napatkitiprasanpong/Closed-Loop-Smart-Insole-for-Diabetic-Foot-Ulcer-Prevention/esp32/esp32s3_insole_board_schematic.pdf

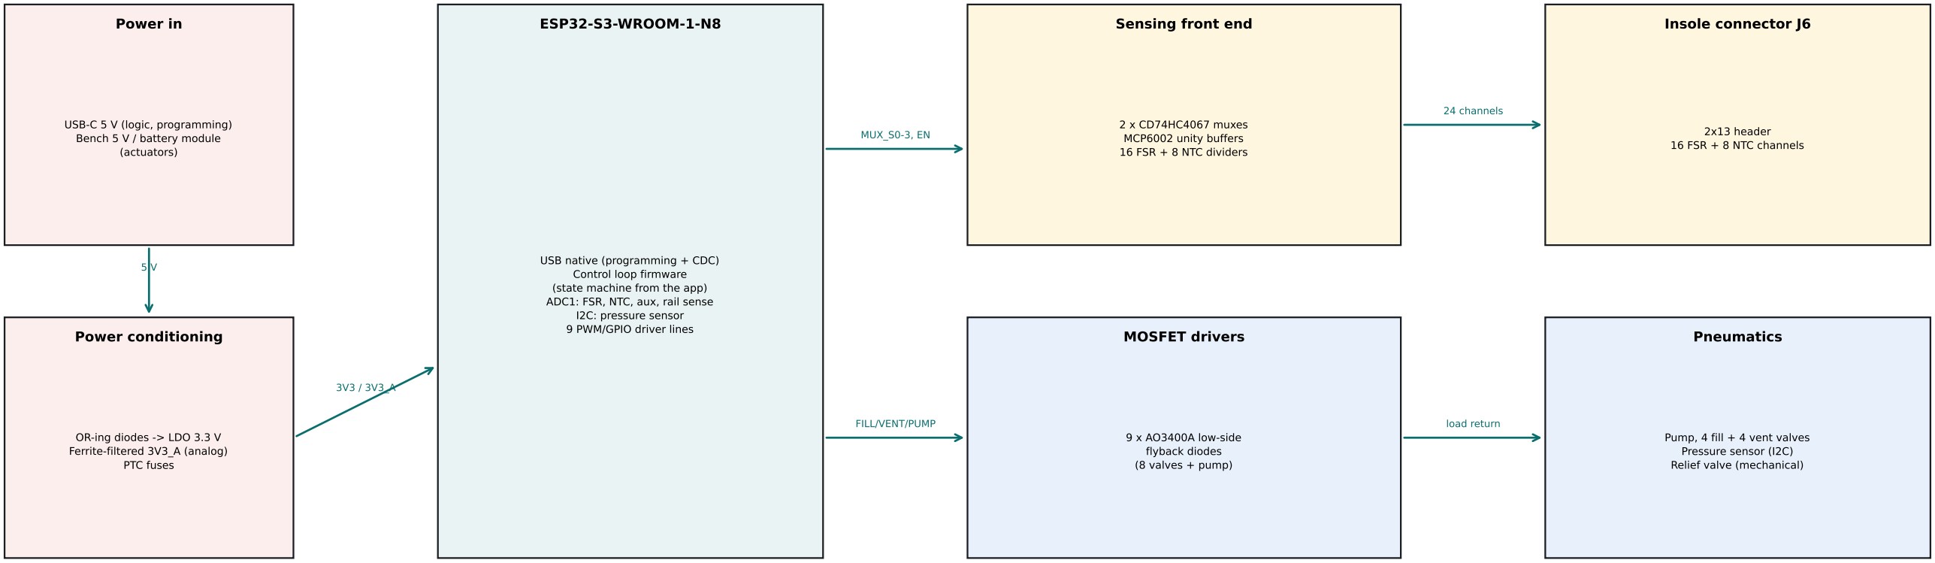
[picture p2: figure]
Power in; USB-C 5 V (logic, programming) Bench 5 V / battery module (actuators); Power conditioning; OR-ing diodes -> LDO 3.3 V Ferrite-filtered 3V3_A (analog) PTC fuses; ESP32-S3-WROOM-1-N8; USB native (programming + CDC) Control loop firmware (state machine from the app) ADC1: FSR, NTC, aux, rail sense I2C: pressure sensor 9 PWM/GPIO driver lines; Sensing front end; 2 x CD74HC4067 muxes MCP6002 unity buffers 16 FSR + 8 NTC dividers; Insole connector J6; 2x13 header 16 FSR + 8 NTC channels; MOSFET drivers; 9 x AO3400A low-side flyback diodes (8 valves + pump); Pneumatics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

### Closed-loop diabetic-foot insole: controller board (ESP32-S3)

Sheet 1/5: System overview and GPIO map | Rev 0.1 concept, 2026-10-03

### Safety path (independent of firmware)

Normally-closed E-stop switch in series with the actuator rail (J3) -> 2.5 A PTC -> V_ACT. Actuator power is cut in hardware; the MCU senses V_ACT on IO5 and stays powered.

Safe state: all valves and the pump are normally off (de-energised) when power is lost or the E-stop opens, so every bladder holds its last pressure. Vent valves are normally closed: a powered vent (or the mechanical relief valve) is needed to release pressure. Choose valve types accordingly.

Assumed loads (to confirm with real parts)

MCU module: about 100-350 mA (Wi-Fi bursts) | analog section: <20 mA
Actuator rail sized for 2.5 A (pump about 0.3-1 A, valves about 0.1-0.25 A each, only some energised at once)

### GPIO assignment

IO0 | BOOT | strapping: BOOT button
IO1 | FSR_ADC | ADC1_CH0
IO2 | NTC_ADC | ADC1_CH1
IO4 | AUX_ADC | ADC1_CH3, expansion header
IO5 | ACT_SENSE | ADC1_CH4, V_ACT sense
IO6 | AUX_IO | expansion header
IO7 | LED_STATUS
IO8 | I2C_SDA
IO9 | I2C_SCL
IO10 | MUX_S0
IO11 | MUX_S1
IO12 | MUX_S2
IO13 | MUX_S3
IO14 | MUX_EN_N
IO15 | FILL1
IO16 | FILL2
IO17 | FILL3
IO18 | FILL4
IO19 | USB_DN | native USB D-
IO20 | USB_DP | native USB D+
IO21 | VENT1
IO38 | VENT2
IO39 | VENT3
IO40 | VENT4
IO41 | PUMP_PWM
IO42 | BUZZER
IO43 | UART0_TX | UART0 TX
IO44 | UART0_RX | UART0 RX

Not used (reserved): IO3, IO45, IO46 (strapping), IO26-IO32 (flash), IO35-IO37 (octal-PSRAM variants), IO47/IO48. IO39-IO42 are the default pad-JTAG pins; debugging uses the USB Serial/JTAG port instead.

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

Sheet 3/5: Sensor front end: multiplexers, buffers, dividers, insole connector | Rev 0.1 concept, 2026-10-03

U3

CD74HC4067M (FSR)

FSR_N0 | I0
FSR_N1 | I1
FSR_N2 | I2
FSR_N3 | I3
FSR_N4 | I4
FSR_N5 | I5
FSR_N6 | I6
FSR_N7 | I7
FSR_N8 | I8
FSR_N9 | I9
FSR_N10 | I10
FSR_N11 | I11
FSR_N12 | I12
FSR_N13 | I13
FSR_N14 | I14
FSR_N15 | I15
S0 | MUX_S0
S1 | MUX_S1
S2 | MUX_S2
S3 | MUX_S3
~E | MUX_EN_N
GND | GND
VCC | 3V3_A
COM | FSR_MUX

U4

CD74HC4067M (NTC)

NTC_N0 | I0
NTC_N1 | I1
NTC_N2 | I2
NTC_N3 | I3
NTC_N4 | I4
NTC_N5 | I5
NTC_N6 | I6
NTC_N7 | I7
GND | I8
GND | I9
GND | I10
GND | I11
GND | I12
GND | I13
GND | I14
GND | I15
S0 | MUX_S0
S1 | MUX_S1
S2 | MUX_S2
S3 | MUX_S3
~E | MUX_EN_N
GND | GND
VCC | 3V3_A
COM | NTC_MUX

U5

MCP6002

FSR_BUF | 1
FSR_BUF | 2
FSR_MUX | 3
GND | 4
8 | 3V3_A
7 | NTC_BUF
6 | NTC_BUF
5 | NTC_MUX

J6

SENSORS

3V3_A | 1
FSR_N0 | 2
FSR_N1 | 3
FSR_N2 | 4
FSR_N3 | 5
FSR_N4 | 6
FSR_N5 | 7
FSR_N6 | 8
FSR_N7 | 9
FSR_N8 | 10
FSR_N9 | 11
FSR_N10 | 12
FSR_N11 | 13
FSR_N12 | 14
FSR_N13 | 15
FSR_N14 | 16
FSR_N15 | 17
GND | 18
NTC_N0 | 19
NTC_N1 | 20
NTC_N2 | 21
NTC_N3 | 22
NTC_N4 | 23
NTC_N5 | 24
NTC_N6 | 25
NTC_N7 | 26

Per-channel dividers

FSR (x16): sensor from 3V3_A (J6 pin 1)
to FSR_Nx; RFx 10k from FSR_Nx to GND.
NTC (x8): RNx 10k 0.1% from 3V3_A to NTC_Nx; thermistor from NTC_Nx to GND (J6 pin 18). Unused/unplugged channels read 0 V (FSR)
or near 3V3_A (NTC): no floating inputs.
FSR_N0 | GND

RF0 10k

FSR_N1 | GND

RF1 10k

3V3_A | NTC_N0

RN0 10k

3V3_A | NTC_N1

RN1 10k

(RF0-RF15 and RN0-RN7 follow the same pattern; see netlist.csv for all channels.)

Buffer outputs and ADC filters

FSR_BUF | FSR_ADC

R10 1k

FSR_ADC | GND

C12 100nF

NTC_BUF | NTC_ADC

R11 1k

NTC_ADC | GND

C13 100nF

Decoupling at U3, U4, U5 (100 nF each)

3V3_A | GND

C9 100nF

3V3_A | GND

C10 100nF

3V3_A | GND

C11 100nF

Mux enable pull-up

3V3 | MUX_EN_N

R9 10k

Scan: set S0-S3, wait about 0.3 ms, read FSR_ADC (IO1) and NTC_ADC (IO2) together. U4 inputs I8-I15 are tied to GND. Ron of the mux is
absorbed by the op-amp buffers.

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

Sheet 5/5: Suggested placement (floorplan, not a routed layout) | Rev 0.1 concept, 2026-10-03

Board outline about 90 x 65 mm (drawn at 3:1). 4-layer stack recommended: signal / GND / power / signal.

ESP32-S3-
WROOM-1
(18 x 25.5 mm)

antenna end at the board edge: no copper, GND or parts under or beside it

USB-C

Buttons,
LEDs,
debug

Power: LDO,
OR-ing diodes,
fuses

Analog: 2 muxes,
op-amp, dividers

J6 sensor header (bottom edge)

Actuator drivers:
MOSFETs, diodes,
bulk caps

Valve / pump / E-stop / bench terminals (right edge)

Placement guidance

1. Antenna at the board edge. 2. USB D+/D- as a short, matched pair with no stubs. 3. Switching loads (pump, valves) on the right, analog on the left.
4. J6 and the ADC filters next to the muxes; keep actuator return currents out from under the analog section. 5. Solid GND plane under the muxes and op-amp.
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
