napatkitiprasanpong/Closed-Loop-Smart-Insole-for-Diabetic-Foot-Ulcer-Prevention/esp32/sheet2.png

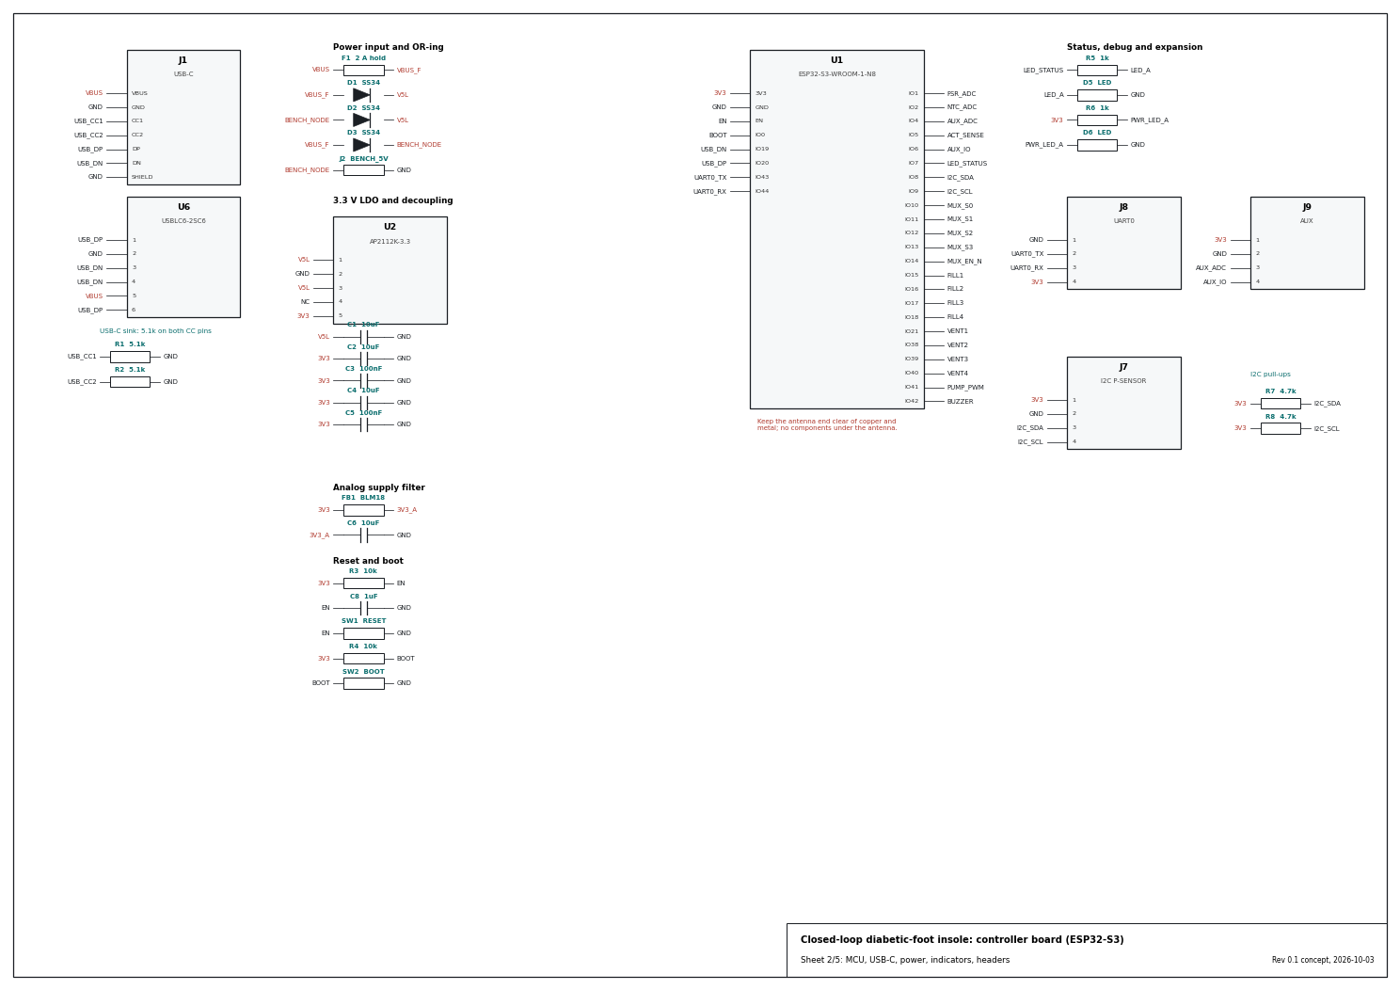
esp32/sheet2.png
