napatkitiprasanpong/Closed-Loop-Smart-Insole-for-Diabetic-Foot-Ulcer-Prevention/insole-cad/plan_view.png

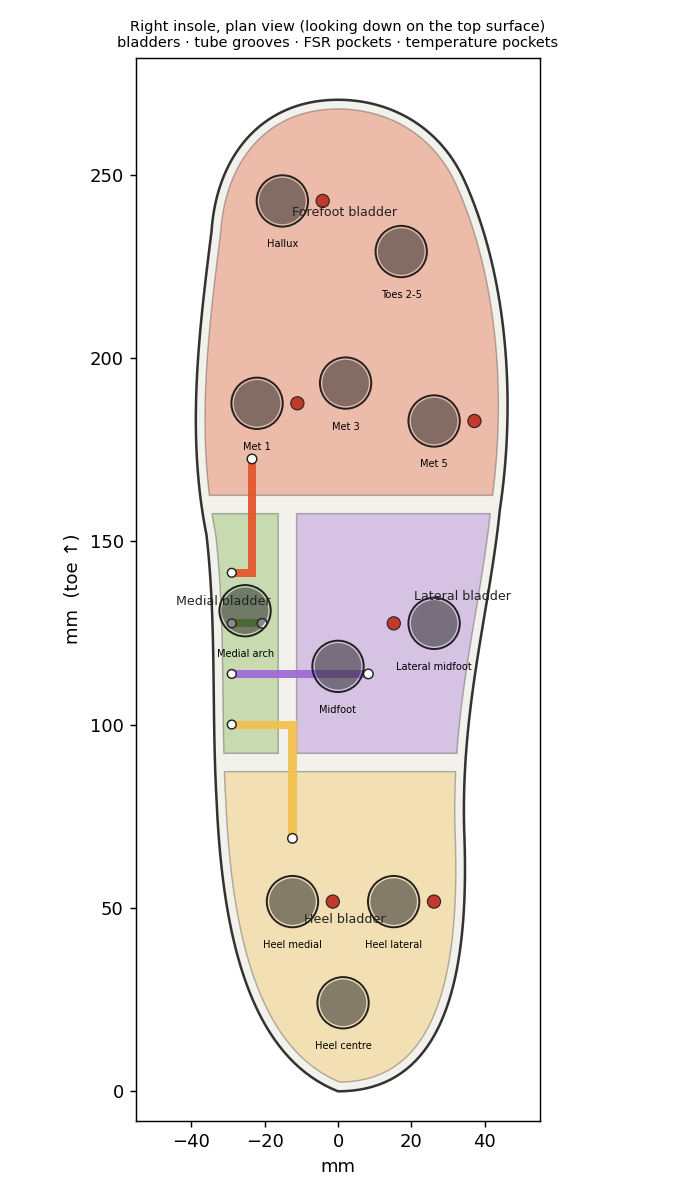
insole-cad/plan_view.png
