napatkitiprasanpong/Closed-Loop-Smart-Insole-for-Diabetic-Foot-Ulcer-Prevention/esp32/BOM.xlsx

Controller board BOM (concept rev 0.1)
Part numbers are given only where I am confident of them; other lines are generic specs. Check every line against current datasheets and stock before ordering.
Designators | Qty | Description | Value | Footprint | Part number | Notes
J1 | 1 | USB-C receptacle (USB 2.0, 16-pin) | USB-C | USB_C_Receptacle_16P | GCT USB4105-GF-A
J2 | 1 | Bench 5 V input / battery-module input (screw terminal 5.08 mm) | BENCH_5V | TerminalBlock_5.08_2P
J3 | 1 | E-stop switch terminal (normally-closed) | E-STOP | TerminalBlock_5.08_2P
J4 | 1 | Pump terminal | PUMP | JST_XH_1x02
J5 | 1 | Valve block header (1x9, 2.54 mm) | VALVES | PinHeader_1x09 |  | Pin 1 = valve supply (common), 2-5 = fill valves 1-4, 6-9 = vent valves 1-4
J6 | 1 | Insole sensor connector (2x13, 2.54 mm) | SENSORS | PinHeader_2x13 |  | Pin 1 = sensor supply (FSR common), 2-17 = FSR 0-15, 18 = sensor GND, 19-26 = NTC 0-7. Add TVS/ESD arrays here in layout
J7 | 1 | I2C pressure-sensor header (1x4, JST-SH) | I2C P-SENSOR | JST_SH_1x04 |  | For an I2C gauge pressure sensor module (range about 0 to 100 kPa). Part choice still open
J8 | 1 | Debug UART header (1x4, 2.54 mm) | UART0 | PinHeader_1x04
J9 | 1 | Expansion header (1x4, 2.54 mm) | AUX | PinHeader_1x04
Q1 | 1 | N-MOSFET low-side driver, Fill valve 1 | AO3400A | SOT-23 | AO3400A
Q2 | 1 | N-MOSFET low-side driver, Fill valve 2 | AO3400A | SOT-23 | AO3400A
Q3 | 1 | N-MOSFET low-side driver, Fill valve 3 | AO3400A | SOT-23 | AO3400A
Q4 | 1 | N-MOSFET low-side driver, Fill valve 4 | AO3400A | SOT-23 | AO3400A
Q5 | 1 | N-MOSFET low-side driver, Vent valve 1 | AO3400A | SOT-23 | AO3400A
Q6 | 1 | N-MOSFET low-side driver, Vent valve 2 | AO3400A | SOT-23 | AO3400A
Q7 | 1 | N-MOSFET low-side driver, Vent valve 3 | AO3400A | SOT-23 | AO3400A
Q8 | 1 | N-MOSFET low-side driver, Vent valve 4 | AO3400A | SOT-23 | AO3400A
Q9 | 1 | N-MOSFET low-side driver, Pump | AO3400A | SOT-23 | AO3400A
Q10 | 1 | N-MOSFET low-side driver, buzzer | AO3400A | SOT-23 | AO3400A
U1 | 1 | ESP32-S3 module, 8 MB flash, no PSRAM | ESP32-S3-WROOM-1-N8 | ESP32-S3-WROOM-1 | ESP32-S3-WROOM-1-N8 | Pins keyed by IO number; map to pad numbers from the KiCad library symbol
U2 | 1 | 3.3 V LDO, 600 mA | AP2112K-3.3 | SOT-23-5 | AP2112K-3.3TRG1
U3 | 1 | 16:1 analog multiplexer (FSR) | CD74HC4067M | SOIC-24W | CD74HC4067M
U4 | 1 | 16:1 analog multiplexer (NTC) | CD74HC4067M | SOIC-24W | CD74HC4067M
U5 | 1 | Dual rail-to-rail op-amp, unity-gain buffers | MCP6002 | SOIC-8 | MCP6002-I/SN
U6 | 1 | USB ESD protection | USBLC6-2SC6 | SOT-23-6 | USBLC6-2SC6
C1, C2, C4, C6, C15 | 5 | Capacitor | 10uF | C_0805
C3, C5, C7, C9, C10, C11, C12, C13, C16 | 9 | Capacitor | 100nF | C_0603
C8 | 1 | Capacitor | 1uF | C_0603
C14 | 1 | Capacitor | 220uF | CP_6.3x5.4
D1, D2 | 2 | Schottky diode | SS34 | D_SMA | SS34
D3 | 1 | Schottky diode | SS34 | D_SMA | SS34 | DNP by default. Populate for single-cable bench mode (USB powers actuators too; limited by the USB source)
D5 | 1 | LED green (status) | LED | LED_0603
D6 | 1 | LED red (power) | LED | LED_0603
D20, D21, D22, D23, D24, D25, D26, D27 | 8 | Flyback diode | SS14 | D_SMA | SS14
D28 | 1 | Flyback diode | SS34 | D_SMA | SS34
F1 | 1 | Resettable fuse, USB input | 2 A hold | F_1812 |  | PTC
FB1 | 1 | Ferrite bead 600 ohm @100 MHz, 1 A | BLM18 | L_0603
F2 | 1 | Resettable fuse, actuator rail | 2.5 A hold | F_1812 |  | PTC
LS1 | 1 | Active buzzer, 3.3 V | BUZZER | Buzzer_12x9.5 |  | If a magnetic buzzer is used, add a flyback diode
R1, R2 | 2 | Resistor | 5.1k | R_0603
RF0, RN0, RF1, RN1, RF2, RN2, R3, RF3, RN3, R4, RF4, RN4, RF5, RN5, RF6, RN6, RF7, RN7, RF8, R9, RF9, RF10, RF11, RF12, R12, RF13, RF14, RF15 | 28 | Resistor | 10k | R_0603
R5, R6, R10, R11 | 4 | Resistor | 1k | R_0603
R7, R8 | 2 | Resistor | 4.7k | R_0603
R13 | 1 | Resistor | 15k | R_0603
R14, R16, R18, R20, R22, R24, R26, R28, R30, R32 | 10 | Resistor | 100 | R_0603
R15, R17, R19, R21, R23, R25, R27, R29, R31, R33 | 10 | Resistor | 100k | R_0603
SW1 | 1 | Tactile switch (RESET) | RESET | SW_SMD_3x4
SW2 | 1 | Tactile switch (BOOT) | BOOT | SW_SMD_3x4
