napatkitiprasanpong/Closed-Loop-Smart-Insole-for-Diabetic-Foot-Ulcer-Prevention/esp32/netlist.csv

ref | pin | net | part_value | footprint
C1 | 1 | V5L | 10uF | C_0805
C1 | 2 | GND | 10uF | C_0805
C2 | 1 | 3V3 | 10uF | C_0805
C2 | 2 | GND | 10uF | C_0805
C3 | 1 | 3V3 | 100nF | C_0603
C3 | 2 | GND | 100nF | C_0603
C4 | 1 | 3V3 | 10uF | C_0805
C4 | 2 | GND | 10uF | C_0805
C5 | 1 | 3V3 | 100nF | C_0603
C5 | 2 | GND | 100nF | C_0603
C6 | 1 | 3V3_A | 10uF | C_0805
C6 | 2 | GND | 10uF | C_0805
C7 | 1 | 3V3_A | 100nF | C_0603
C7 | 2 | GND | 100nF | C_0603
C8 | 1 | EN | 1uF | C_0603
C8 | 2 | GND | 1uF | C_0603
C9 | 1 | 3V3_A | 100nF | C_0603
C9 | 2 | GND | 100nF | C_0603
C10 | 1 | 3V3_A | 100nF | C_0603
C10 | 2 | GND | 100nF | C_0603
C11 | 1 | 3V3_A | 100nF | C_0603
C11 | 2 | GND | 100nF | C_0603
C12 | 1 | FSR_ADC | 100nF | C_0603
C12 | 2 | GND | 100nF | C_0603
C13 | 1 | NTC_ADC | 100nF | C_0603
C13 | 2 | GND | 100nF | C_0603
C14 | 1 | V_ACT | 220uF | CP_6.3x5.4
C14 | 2 | GND | 220uF | CP_6.3x5.4
C15 | 1 | V_ACT | 10uF | C_0805
C15 | 2 | GND | 10uF | C_0805
C16 | 1 | ACT_SENSE | 100nF | C_0603
C16 | 2 | GND | 100nF | C_0603
D1 | A | VBUS_F | SS34 | D_SMA
D1 | K | V5L | SS34 | D_SMA
D2 | A | BENCH_NODE | SS34 | D_SMA
D2 | K | V5L | SS34 | D_SMA
D3 | A | VBUS_F | SS34 | D_SMA
D3 | K | BENCH_NODE | SS34 | D_SMA
D5 | A | LED_A | LED | LED_0603
D5 | K | GND | LED | LED_0603
D6 | A | PWR_LED_A | LED | LED_0603
D6 | K | GND | LED | LED_0603
D20 | A | DRV_FILL1 | SS14 | D_SMA
D20 | K | V_ACT | SS14 | D_SMA
D21 | A | DRV_FILL2 | SS14 | D_SMA
D21 | K | V_ACT | SS14 | D_SMA
D22 | A | DRV_FILL3 | SS14 | D_SMA
D22 | K | V_ACT | SS14 | D_SMA
D23 | A | DRV_FILL4 | SS14 | D_SMA
D23 | K | V_ACT | SS14 | D_SMA
D24 | A | DRV_VENT1 | SS14 | D_SMA
D24 | K | V_ACT | SS14 | D_SMA
D25 | A | DRV_VENT2 | SS14 | D_SMA
D25 | K | V_ACT | SS14 | D_SMA
D26 | A | DRV_VENT3 | SS14 | D_SMA
D26 | K | V_ACT | SS14 | D_SMA
D27 | A | DRV_VENT4 | SS14 | D_SMA
D27 | K | V_ACT | SS14 | D_SMA
D28 | A | PUMP_N | SS34 | D_SMA
D28 | K | V_ACT | SS34 | D_SMA
F1 | 1 | VBUS | 2 A hold | F_1812
F1 | 2 | VBUS_F | 2 A hold | F_1812
FB1 | 1 | 3V3 | BLM18 | L_0603
FB1 | 2 | 3V3_A | BLM18 | L_0603
F2 | 1 | ESTOP_OUT | 2.5 A hold | F_1812
F2 | 2 | V_ACT | 2.5 A hold | F_1812
J1 | VBUS | VBUS | USB-C | USB_C_Receptacle_16P
J1 | GND | GND | USB-C | USB_C_Receptacle_16P
J1 | CC1 | USB_CC1 | USB-C | USB_C_Receptacle_16P
J1 | CC2 | USB_CC2 | USB-C | USB_C_Receptacle_16P
J1 | DP | USB_DP | USB-C | USB_C_Receptacle_16P
J1 | DN | USB_DN | USB-C | USB_C_Receptacle_16P
J1 | SHIELD | GND | USB-C | USB_C_Receptacle_16P
J2 | 1 | BENCH_NODE | BENCH_5V | TerminalBlock_5.08_2P
J2 | 2 | GND | BENCH_5V | TerminalBlock_5.08_2P
J3 | 1 | BENCH_NODE | E-STOP | TerminalBlock_5.08_2P
J3 | 2 | ESTOP_OUT | E-STOP | TerminalBlock_5.08_2P
J4 | 1 | V_ACT | PUMP | JST_XH_1x02
J4 | 2 | PUMP_N | PUMP | JST_XH_1x02
J5 | 1 | V_ACT | VALVES | PinHeader_1x09
J5 | 2 | DRV_FILL1 | VALVES | PinHeader_1x09
J5 | 3 | DRV_FILL2 | VALVES | PinHeader_1x09
J5 | 4 | DRV_FILL3 | VALVES | PinHeader_1x09
J5 | 5 | DRV_FILL4 | VALVES | PinHeader_1x09
J5 | 6 | DRV_VENT1 | VALVES | PinHeader_1x09
J5 | 7 | DRV_VENT2 | VALVES | PinHeader_1x09
J5 | 8 | DRV_VENT3 | VALVES | PinHeader_1x09
J5 | 9 | DRV_VENT4 | VALVES | PinHeader_1x09
J6 | 1 | 3V3_A | SENSORS | PinHeader_2x13
J6 | 2 | FSR_N0 | SENSORS | PinHeader_2x13
J6 | 3 | FSR_N1 | SENSORS | PinHeader_2x13
J6 | 4 | FSR_N2 | SENSORS | PinHeader_2x13
J6 | 5 | FSR_N3 | SENSORS | PinHeader_2x13
J6 | 6 | FSR_N4 | SENSORS | PinHeader_2x13
J6 | 7 | FSR_N5 | SENSORS | PinHeader_2x13
J6 | 8 | FSR_N6 | SENSORS | PinHeader_2x13
J6 | 9 | FSR_N7 | SENSORS | PinHeader_2x13
J6 | 10 | FSR_N8 | SENSORS | PinHeader_2x13
J6 | 11 | FSR_N9 | SENSORS | PinHeader_2x13
J6 | 12 | FSR_N10 | SENSORS | PinHeader_2x13
J6 | 13 | FSR_N11 | SENSORS | PinHeader_2x13
J6 | 14 | FSR_N12 | SENSORS | PinHeader_2x13
J6 | 15 | FSR_N13 | SENSORS | PinHeader_2x13
J6 | 16 | FSR_N14 | SENSORS | PinHeader_2x13
J6 | 17 | FSR_N15 | SENSORS | PinHeader_2x13
J6 | 18 | GND | SENSORS | PinHeader_2x13
J6 | 19 | NTC_N0 | SENSORS | PinHeader_2x13
J6 | 20 | NTC_N1 | SENSORS | PinHeader_2x13
J6 | 21 | NTC_N2 | SENSORS | PinHeader_2x13
J6 | 22 | NTC_N3 | SENSORS | PinHeader_2x13
J6 | 23 | NTC_N4 | SENSORS | PinHeader_2x13
J6 | 24 | NTC_N5 | SENSORS | PinHeader_2x13
J6 | 25 | NTC_N6 | SENSORS | PinHeader_2x13
J6 | 26 | NTC_N7 | SENSORS | PinHeader_2x13
J7 | 1 | 3V3 | I2C P-SENSOR | JST_SH_1x04
J7 | 2 | GND | I2C P-SENSOR | JST_SH_1x04
J7 | 3 | I2C_SDA | I2C P-SENSOR | JST_SH_1x04
J7 | 4 | I2C_SCL | I2C P-SENSOR | JST_SH_1x04
J8 | 1 | GND | UART0 | PinHeader_1x04
J8 | 2 | UART0_TX | UART0 | PinHeader_1x04
J8 | 3 | UART0_RX | UART0 | PinHeader_1x04
J8 | 4 | 3V3 | UART0 | PinHeader_1x04
J9 | 1 | 3V3 | AUX | PinHeader_1x04
J9 | 2 | GND | AUX | PinHeader_1x04
J9 | 3 | AUX_ADC | AUX | PinHeader_1x04
J9 | 4 | AUX_IO | AUX | PinHeader_1x04
LS1 | 1 | 3V3 | BUZZER | Buzzer_12x9.5
LS1 | 2 | BZ_N | BUZZER | Buzzer_12x9.5
Q1 | 1 | G_FILL1 | AO3400A | SOT-23
Q1 | 2 | GND | AO3400A | SOT-23
Q1 | 3 | DRV_FILL1 | AO3400A | SOT-23
Q2 | 1 | G_FILL2 | AO3400A | SOT-23
Q2 | 2 | GND | AO3400A | SOT-23
Q2 | 3 | DRV_FILL2 | AO3400A | SOT-23
Q3 | 1 | G_FILL3 | AO3400A | SOT-23
Q3 | 2 | GND | AO3400A | SOT-23
Q3 | 3 | DRV_FILL3 | AO3400A | SOT-23
Q4 | 1 | G_FILL4 | AO3400A | SOT-23
Q4 | 2 | GND | AO3400A | SOT-23
Q4 | 3 | DRV_FILL4 | AO3400A | SOT-23
Q5 | 1 | G_VENT1 | AO3400A | SOT-23
Q5 | 2 | GND | AO3400A | SOT-23
Q5 | 3 | DRV_VENT1 | AO3400A | SOT-23
Q6 | 1 | G_VENT2 | AO3400A | SOT-23
Q6 | 2 | GND | AO3400A | SOT-23
Q6 | 3 | DRV_VENT2 | AO3400A | SOT-23
Q7 | 1 | G_VENT3 | AO3400A | SOT-23
Q7 | 2 | GND | AO3400A | SOT-23
Q7 | 3 | DRV_VENT3 | AO3400A | SOT-23
Q8 | 1 | G_VENT4 | AO3400A | SOT-23
Q8 | 2 | GND | AO3400A | SOT-23
Q8 | 3 | DRV_VENT4 | AO3400A | SOT-23
Q9 | 1 | G_PUMP | AO3400A | SOT-23
Q9 | 2 | GND | AO3400A | SOT-23
Q9 | 3 | PUMP_N | AO3400A | SOT-23
Q10 | 1 | G_BZ | AO3400A | SOT-23
Q10 | 2 | GND | AO3400A | SOT-23
Q10 | 3 | BZ_N | AO3400A | SOT-23
RF0 | 1 | FSR_N0 | 10k | R_0603
RF0 | 2 | GND | 10k | R_0603
RN0 | 1 | 3V3_A | 10k | R_0603
RN0 | 2 | NTC_N0 | 10k | R_0603
R1 | 1 | USB_CC1 | 5.1k | R_0603
R1 | 2 | GND | 5.1k | R_0603
RF1 | 1 | FSR_N1 | 10k | R_0603
RF1 | 2 | GND | 10k | R_0603
RN1 | 1 | 3V3_A | 10k | R_0603
RN1 | 2 | NTC_N1 | 10k | R_0603
R2 | 1 | USB_CC2 | 5.1k | R_0603
R2 | 2 | GND | 5.1k | R_0603
RF2 | 1 | FSR_N2 | 10k | R_0603
RF2 | 2 | GND | 10k | R_0603
RN2 | 1 | 3V3_A | 10k | R_0603
RN2 | 2 | NTC_N2 | 10k | R_0603
R3 | 1 | 3V3 | 10k | R_0603
R3 | 2 | EN | 10k | R_0603
RF3 | 1 | FSR_N3 | 10k | R_0603
RF3 | 2 | GND | 10k | R_0603
RN3 | 1 | 3V3_A | 10k | R_0603
RN3 | 2 | NTC_N3 | 10k | R_0603
R4 | 1 | 3V3 | 10k | R_0603
R4 | 2 | BOOT | 10k | R_0603
RF4 | 1 | FSR_N4 | 10k | R_0603
RF4 | 2 | GND | 10k | R_0603
RN4 | 1 | 3V3_A | 10k | R_0603
RN4 | 2 | NTC_N4 | 10k | R_0603
R5 | 1 | LED_STATUS | 1k | R_0603
R5 | 2 | LED_A | 1k | R_0603
RF5 | 1 | FSR_N5 | 10k | R_0603
RF5 | 2 | GND | 10k | R_0603
RN5 | 1 | 3V3_A | 10k | R_0603
RN5 | 2 | NTC_N5 | 10k | R_0603
R6 | 1 | 3V3 | 1k | R_0603
R6 | 2 | PWR_LED_A | 1k | R_0603
RF6 | 1 | FSR_N6 | 10k | R_0603
RF6 | 2 | GND | 10k | R_0603
RN6 | 1 | 3V3_A | 10k | R_0603
RN6 | 2 | NTC_N6 | 10k | R_0603
R7 | 1 | 3V3 | 4.7k | R_0603
R7 | 2 | I2C_SDA | 4.7k | R_0603
RF7 | 1 | FSR_N7 | 10k | R_0603
RF7 | 2 | GND | 10k | R_0603
RN7 | 1 | 3V3_A | 10k | R_0603
RN7 | 2 | NTC_N7 | 10k | R_0603
R8 | 1 | 3V3 | 4.7k | R_0603
R8 | 2 | I2C_SCL | 4.7k | R_0603
RF8 | 1 | FSR_N8 | 10k | R_0603
RF8 | 2 | GND | 10k | R_0603
R9 | 1 | 3V3 | 10k | R_0603
R9 | 2 | MUX_EN_N | 10k | R_0603
RF9 | 1 | FSR_N9 | 10k | R_0603
RF9 | 2 | GND | 10k | R_0603
R10 | 1 | FSR_BUF | 1k | R_0603
R10 | 2 | FSR_ADC | 1k | R_0603
RF10 | 1 | FSR_N10 | 10k | R_0603
RF10 | 2 | GND | 10k | R_0603
R11 | 1 | NTC_BUF | 1k | R_0603
R11 | 2 | NTC_ADC | 1k | R_0603
RF11 | 1 | FSR_N11 | 10k | R_0603
RF11 | 2 | GND | 10k | R_0603
RF12 | 1 | FSR_N12 | 10k | R_0603
RF12 | 2 | GND | 10k | R_0603
R12 | 1 | V_ACT | 10k | R_0603
R12 | 2 | ACT_SENSE | 10k | R_0603
RF13 | 1 | FSR_N13 | 10k | R_0603
RF13 | 2 | GND | 10k | R_0603
R13 | 1 | ACT_SENSE | 15k | R_0603
R13 | 2 | GND | 15k | R_0603
RF14 | 1 | FSR_N14 | 10k | R_0603
RF14 | 2 | GND | 10k | R_0603
R14 | 1 | FILL1 | 100 | R_0603
R14 | 2 | G_FILL1 | 100 | R_0603
RF15 | 1 | FSR_N15 | 10k | R_0603
RF15 | 2 | GND | 10k | R_0603
R15 | 1 | G_FILL1 | 100k | R_0603
R15 | 2 | GND | 100k | R_0603
R16 | 1 | FILL2 | 100 | R_0603
R16 | 2 | G_FILL2 | 100 | R_0603
R17 | 1 | G_FILL2 | 100k | R_0603
R17 | 2 | GND | 100k | R_0603
R18 | 1 | FILL3 | 100 | R_0603
R18 | 2 | G_FILL3 | 100 | R_0603
R19 | 1 | G_FILL3 | 100k | R_0603
R19 | 2 | GND | 100k | R_0603
R20 | 1 | FILL4 | 100 | R_0603
R20 | 2 | G_FILL4 | 100 | R_0603
R21 | 1 | G_FILL4 | 100k | R_0603
R21 | 2 | GND | 100k | R_0603
R22 | 1 | VENT1 | 100 | R_0603
R22 | 2 | G_VENT1 | 100 | R_0603
R23 | 1 | G_VENT1 | 100k | R_0603
R23 | 2 | GND | 100k | R_0603
R24 | 1 | VENT2 | 100 | R_0603
R24 | 2 | G_VENT2 | 100 | R_0603
R25 | 1 | G_VENT2 | 100k | R_0603
R25 | 2 | GND | 100k | R_0603
R26 | 1 | VENT3 | 100 | R_0603
R26 | 2 | G_VENT3 | 100 | R_0603
R27 | 1 | G_VENT3 | 100k | R_0603
R27 | 2 | GND | 100k | R_0603
R28 | 1 | VENT4 | 100 | R_0603
R28 | 2 | G_VENT4 | 100 | R_0603
R29 | 1 | G_VENT4 | 100k | R_0603
R29 | 2 | GND | 100k | R_0603
R30 | 1 | PUMP_PWM | 100 | R_0603
R30 | 2 | G_PUMP | 100 | R_0603
R31 | 1 | G_PUMP | 100k | R_0603
R31 | 2 | GND | 100k | R_0603
R32 | 1 | BUZZER | 100 | R_0603
R32 | 2 | G_BZ | 100 | R_0603
R33 | 1 | G_BZ | 100k | R_0603
R33 | 2 | GND | 100k | R_0603
SW1 | 1 | EN | RESET | SW_SMD_3x4
SW1 | 2 | GND | RESET | SW_SMD_3x4
SW2 | 1 | BOOT | BOOT | SW_SMD_3x4
SW2 | 2 | GND | BOOT | SW_SMD_3x4
U1 | 3V3 | 3V3 | ESP32-S3-WROOM-1-N8 | ESP32-S3-WROOM-1
U1 | GND | GND | ESP32-S3-WROOM-1-N8 | ESP32-S3-WROOM-1
U1 | EN | EN | ESP32-S3-WROOM-1-N8 | ESP32-S3-WROOM-1
U1 | IO0 | BOOT | ESP32-S3-WROOM-1-N8 | ESP32-S3-WROOM-1
U1 | IO1 | FSR_ADC | ESP32-S3-WROOM-1-N8 | ESP32-S3-WROOM-1
U1 | IO2 | NTC_ADC | ESP32-S3-WROOM-1-N8 | ESP32-S3-WROOM-1
U1 | IO4 | AUX_ADC | ESP32-S3-WROOM-1-N8 | ESP32-S3-WROOM-1
U1 | IO5 | ACT_SENSE | ESP32-S3-WROOM-1-N8 | ESP32-S3-WROOM-1
U1 | IO6 | AUX_IO | ESP32-S3-WROOM-1-N8 | ESP32-S3-WROOM-1
U1 | IO7 | LED_STATUS | ESP32-S3-WROOM-1-N8 | ESP32-S3-WROOM-1
U1 | IO8 | I2C_SDA | ESP32-S3-WROOM-1-N8 | ESP32-S3-WROOM-1
U1 | IO9 | I2C_SCL | ESP32-S3-WROOM-1-N8 | ESP32-S3-WROOM-1
U1 | IO10 | MUX_S0 | ESP32-S3-WROOM-1-N8 | ESP32-S3-WROOM-1
U1 | IO11 | MUX_S1 | ESP32-S3-WROOM-1-N8 | ESP32-S3-WROOM-1
U1 | IO12 | MUX_S2 | ESP32-S3-WROOM-1-N8 | ESP32-S3-WROOM-1
U1 | IO13 | MUX_S3 | ESP32-S3-WROOM-1-N8 | ESP32-S3-WROOM-1
U1 | IO14 | MUX_EN_N | ESP32-S3-WROOM-1-N8 | ESP32-S3-WROOM-1
U1 | IO15 | FILL1 | ESP32-S3-WROOM-1-N8 | ESP32-S3-WROOM-1
U1 | IO16 | FILL2 | ESP32-S3-WROOM-1-N8 | ESP32-S3-WROOM-1
U1 | IO17 | FILL3 | ESP32-S3-WROOM-1-N8 | ESP32-S3-WROOM-1
U1 | IO18 | FILL4 | ESP32-S3-WROOM-1-N8 | ESP32-S3-WROOM-1
U1 | IO19 | USB_DN | ESP32-S3-WROOM-1-N8 | ESP32-S3-WROOM-1
U1 | IO20 | USB_DP | ESP32-S3-WROOM-1-N8 | ESP32-S3-WROOM-1
U1 | IO21 | VENT1 | ESP32-S3-WROOM-1-N8 | ESP32-S3-WROOM-1
U1 | IO38 | VENT2 | ESP32-S3-WROOM-1-N8 | ESP32-S3-WROOM-1
U1 | IO39 | VENT3 | ESP32-S3-WROOM-1-N8 | ESP32-S3-WROOM-1
U1 | IO40 | VENT4 | ESP32-S3-WROOM-1-N8 | ESP32-S3-WROOM-1
U1 | IO41 | PUMP_PWM | ESP32-S3-WROOM-1-N8 | ESP32-S3-WROOM-1
U1 | IO42 | BUZZER | ESP32-S3-WROOM-1-N8 | ESP32-S3-WROOM-1
U1 | IO43 | UART0_TX | ESP32-S3-WROOM-1-N8 | ESP32-S3-WROOM-1
U1 | IO44 | UART0_RX | ESP32-S3-WROOM-1-N8 | ESP32-S3-WROOM-1
U2 | 1 | V5L | AP2112K-3.3 | SOT-23-5
U2 | 2 | GND | AP2112K-3.3 | SOT-23-5
U2 | 3 | V5L | AP2112K-3.3 | SOT-23-5
U2 | 4 | NC | AP2112K-3.3 | SOT-23-5
U2 | 5 | 3V3 | AP2112K-3.3 | SOT-23-5
U3 | 1 | FSR_MUX | CD74HC4067M | SOIC-24W
U3 | 10 | MUX_S0 | CD74HC4067M | SOIC-24W
U3 | 11 | MUX_S1 | CD74HC4067M | SOIC-24W
U3 | 12 | GND | CD74HC4067M | SOIC-24W
U3 | 13 | MUX_S3 | CD74HC4067M | SOIC-24W
U3 | 14 | MUX_S2 | CD74HC4067M | SOIC-24W
U3 | 15 | MUX_EN_N | CD74HC4067M | SOIC-24W
U3 | 24 | 3V3_A | CD74HC4067M | SOIC-24W
U3 | 9 | FSR_N0 | CD74HC4067M | SOIC-24W
U3 | 8 | FSR_N1 | CD74HC4067M | SOIC-24W
U3 | 7 | FSR_N2 | CD74HC4067M | SOIC-24W
U3 | 6 | FSR_N3 | CD74HC4067M | SOIC-24W
U3 | 5 | FSR_N4 | CD74HC4067M | SOIC-24W
U3 | 4 | FSR_N5 | CD74HC4067M | SOIC-24W
U3 | 3 | FSR_N6 | CD74HC4067M | SOIC-24W
U3 | 2 | FSR_N7 | CD74HC4067M | SOIC-24W
U3 | 23 | FSR_N8 | CD74HC4067M | SOIC-24W
U3 | 22 | FSR_N9 | CD74HC4067M | SOIC-24W
U3 | 21 | FSR_N10 | CD74HC4067M | SOIC-24W
U3 | 20 | FSR_N11 | CD74HC4067M | SOIC-24W
U3 | 19 | FSR_N12 | CD74HC4067M | SOIC-24W
U3 | 18 | FSR_N13 | CD74HC4067M | SOIC-24W
U3 | 17 | FSR_N14 | CD74HC4067M | SOIC-24W
U3 | 16 | FSR_N15 | CD74HC4067M | SOIC-24W
U4 | 1 | NTC_MUX | CD74HC4067M | SOIC-24W
U4 | 10 | MUX_S0 | CD74HC4067M | SOIC-24W
U4 | 11 | MUX_S1 | CD74HC4067M | SOIC-24W
U4 | 12 | GND | CD74HC4067M | SOIC-24W
U4 | 13 | MUX_S3 | CD74HC4067M | SOIC-24W
U4 | 14 | MUX_S2 | CD74HC4067M | SOIC-24W
U4 | 15 | MUX_EN_N | CD74HC4067M | SOIC-24W
U4 | 24 | 3V3_A | CD74HC4067M | SOIC-24W
U4 | 9 | NTC_N0 | CD74HC4067M | SOIC-24W
U4 | 8 | NTC_N1 | CD74HC4067M | SOIC-24W
U4 | 7 | NTC_N2 | CD74HC4067M | SOIC-24W
U4 | 6 | NTC_N3 | CD74HC4067M | SOIC-24W
U4 | 5 | NTC_N4 | CD74HC4067M | SOIC-24W
U4 | 4 | NTC_N5 | CD74HC4067M | SOIC-24W
U4 | 3 | NTC_N6 | CD74HC4067M | SOIC-24W
U4 | 2 | NTC_N7 | CD74HC4067M | SOIC-24W
U4 | 23 | GND | CD74HC4067M | SOIC-24W
U4 | 22 | GND | CD74HC4067M | SOIC-24W
U4 | 21 | GND | CD74HC4067M | SOIC-24W
U4 | 20 | GND | CD74HC4067M | SOIC-24W
U4 | 19 | GND | CD74HC4067M | SOIC-24W
U4 | 18 | GND | CD74HC4067M | SOIC-24W
U4 | 17 | GND | CD74HC4067M | SOIC-24W
U4 | 16 | GND | CD74HC4067M | SOIC-24W
U5 | 1 | FSR_BUF | MCP6002 | SOIC-8
U5 | 2 | FSR_BUF | MCP6002 | SOIC-8
U5 | 3 | FSR_MUX | MCP6002 | SOIC-8
U5 | 4 | GND | MCP6002 | SOIC-8
U5 | 5 | NTC_MUX | MCP6002 | SOIC-8
U5 | 6 | NTC_BUF | MCP6002 | SOIC-8
U5 | 7 | NTC_BUF | MCP6002 | SOIC-8
U5 | 8 | 3V3_A | MCP6002 | SOIC-8
U6 | 1 | USB_DP | USBLC6-2SC6 | SOT-23-6
U6 | 2 | GND | USBLC6-2SC6 | SOT-23-6
U6 | 3 | USB_DN | USBLC6-2SC6 | SOT-23-6
U6 | 4 | USB_DN | USBLC6-2SC6 | SOT-23-6
U6 | 5 | VBUS | USBLC6-2SC6 | SOT-23-6
U6 | 6 | USB_DP | USBLC6-2SC6 | SOT-23-6
