napatkitiprasanpong/Closed-Loop-Smart-Insole-for-Diabetic-Foot-Ulcer-Prevention/insole-cad/stl/insole_assembly.stl

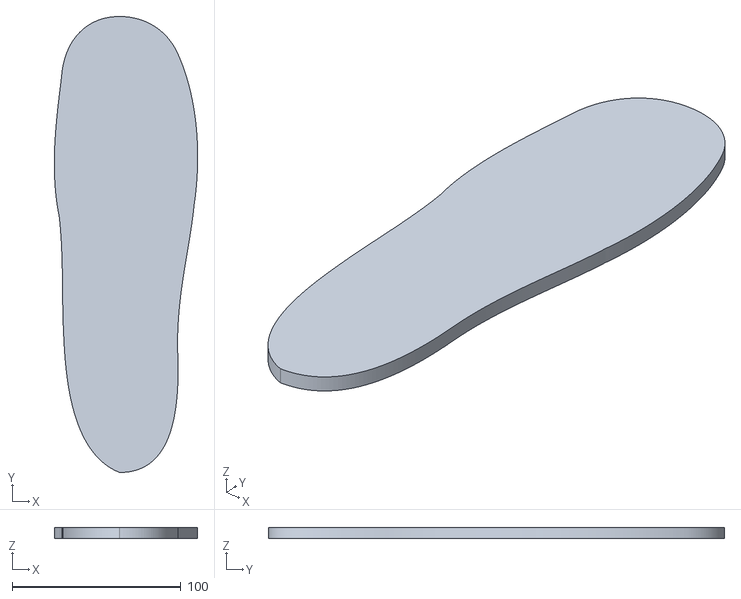
[picture p9: CAD file, 2026-10-17]
insole-cad/stl/insole_assembly.stl
85.0 x 270.5 x 6.60
