napatkitiprasanpong/Closed-Loop-Smart-Insole-for-Diabetic-Foot-Ulcer-Prevention/insole-cad/stl/control_box_components.stl

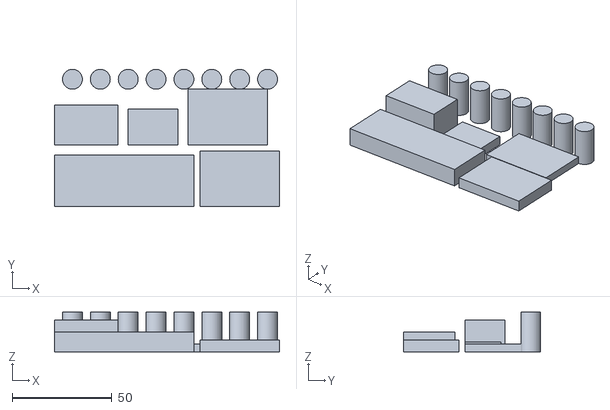
[picture p10: CAD file, 2026-10-20]
insole-cad/stl/control_box_components.stl
113.0 x 69.0 x 20.0
