napatkitiprasanpong/Closed-Loop-Smart-Insole-for-Diabetic-Foot-Ulcer-Prevention/insole-cad/stl/03_pneumatic_layer.stl

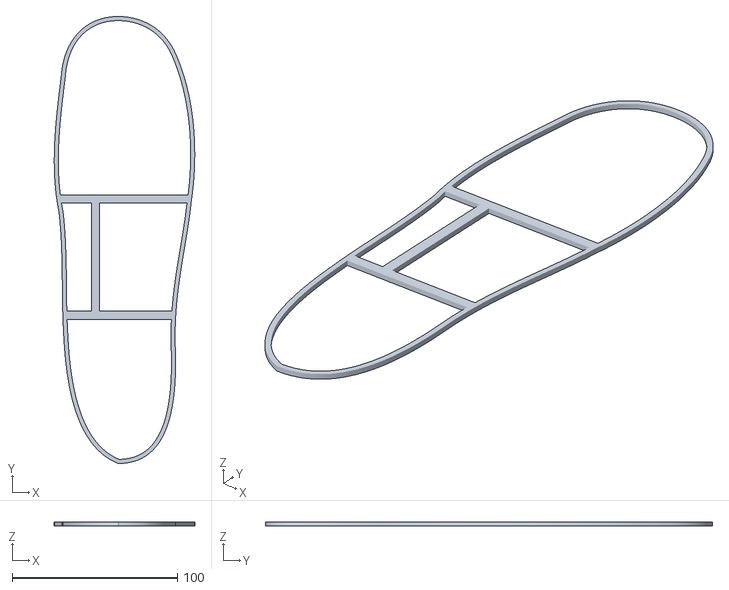
[picture p11: CAD file, 2026-10-17]
insole-cad/stl/03_pneumatic_layer.stl
85.0 x 270.5 x 2.40
