napatkitiprasanpong/Closed-Loop-Smart-Insole-for-Diabetic-Foot-Ulcer-Prevention/insole-cad/stl/02_base_channels.stl

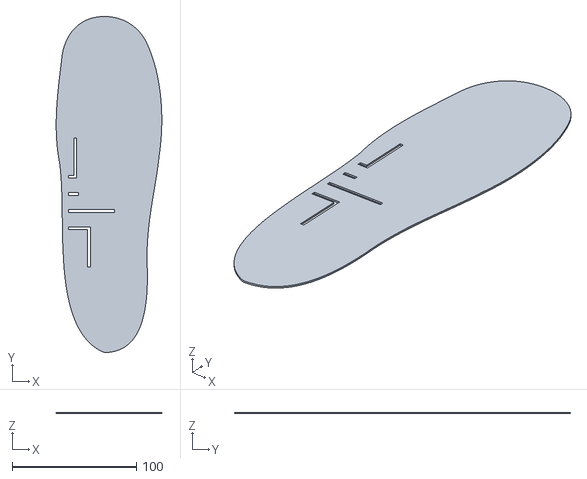
[picture p12: CAD file, 2026-10-17]
insole-cad/stl/02_base_channels.stl
85.0 x 270.5 x 1.00
