napatkitiprasanpong/Closed-Loop-Smart-Insole-for-Diabetic-Foot-Ulcer-Prevention/insole-cad/stl/04_sensor_layer.stl

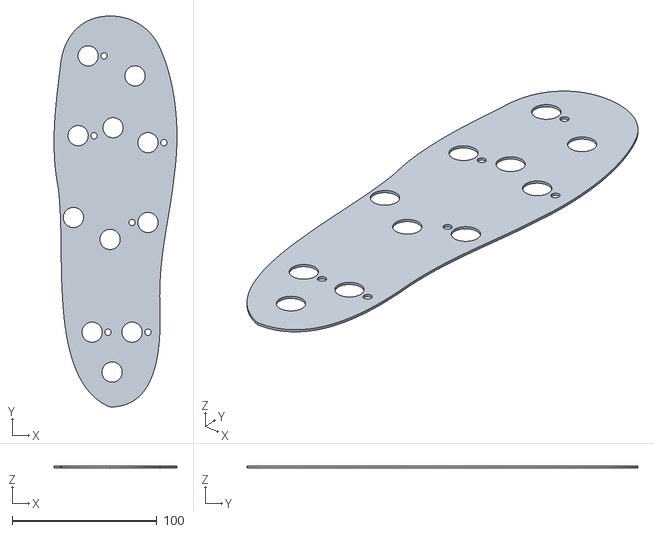
[picture p13: CAD file, 2026-10-17]
insole-cad/stl/04_sensor_layer.stl
85.0 x 270.5 x 1.20
