napatkitiprasanpong/Closed-Loop-Smart-Insole-for-Diabetic-Foot-Ulcer-Prevention/insole-cad/stl/01_base_floor.stl

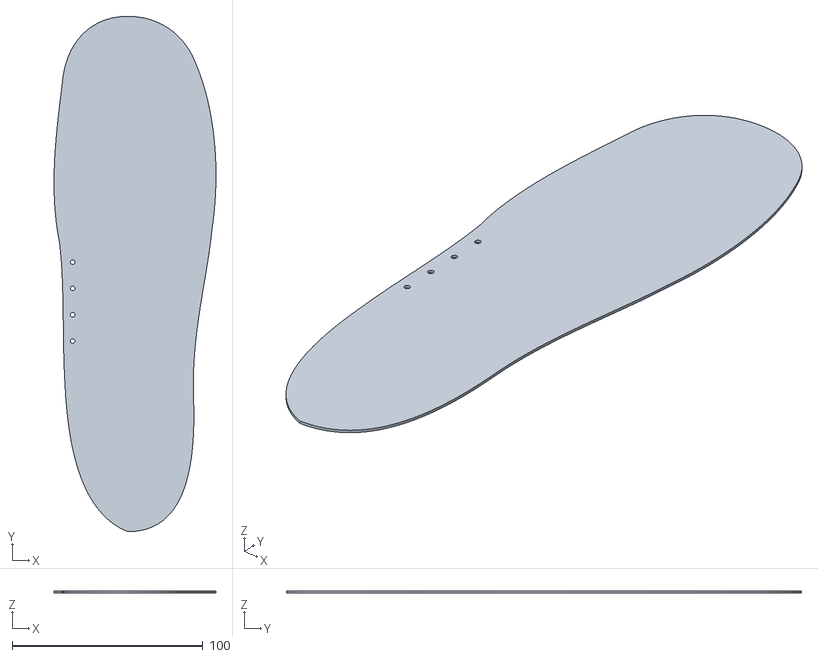
[picture p14: CAD file, 2026-10-17]
insole-cad/stl/01_base_floor.stl
85.0 x 270.5 x 1.00
