napatkitiprasanpong/Closed-Loop-Smart-Insole-for-Diabetic-Foot-Ulcer-Prevention/insole-cad/stl/control_box_enclosure.stl

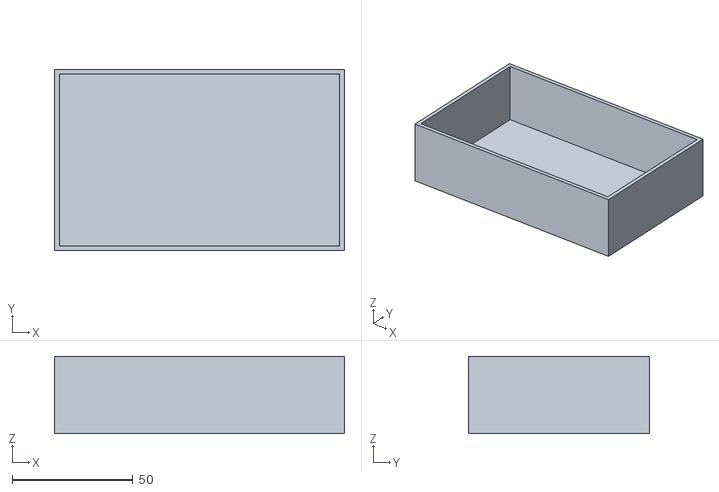
[picture p15: CAD file, 2026-10-17]
insole-cad/stl/control_box_enclosure.stl
120.0 x 75.0 x 32.0
