napatkitiprasanpong/Closed-Loop-Smart-Insole-for-Diabetic-Foot-Ulcer-Prevention/insole-cad/stl/bladder_M.stl

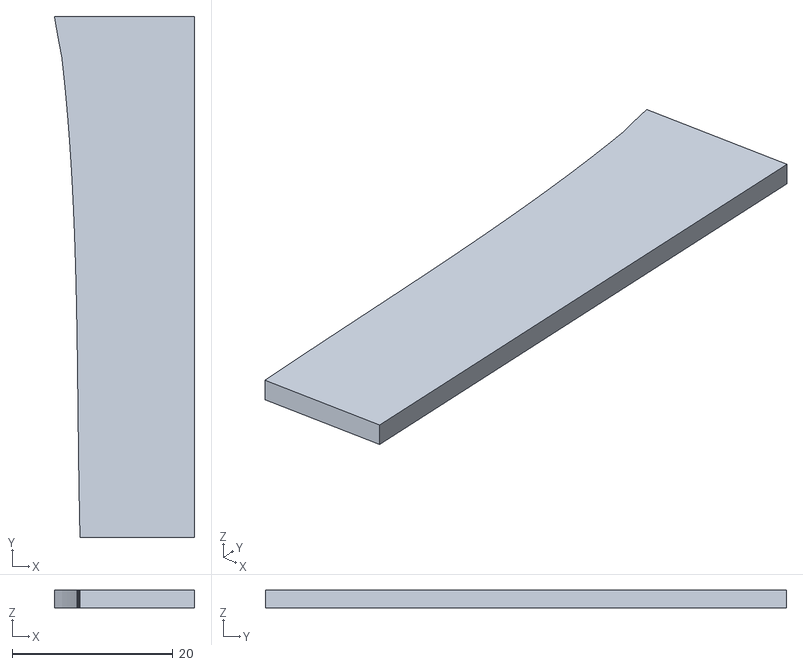
[picture p16: CAD file, 2026-10-17]
insole-cad/stl/bladder_M.stl
17.4 x 64.8 x 2.20
