napatkitiprasanpong/Closed-Loop-Smart-Insole-for-Diabetic-Foot-Ulcer-Prevention/insole-cad/stl/bladder_F.stl

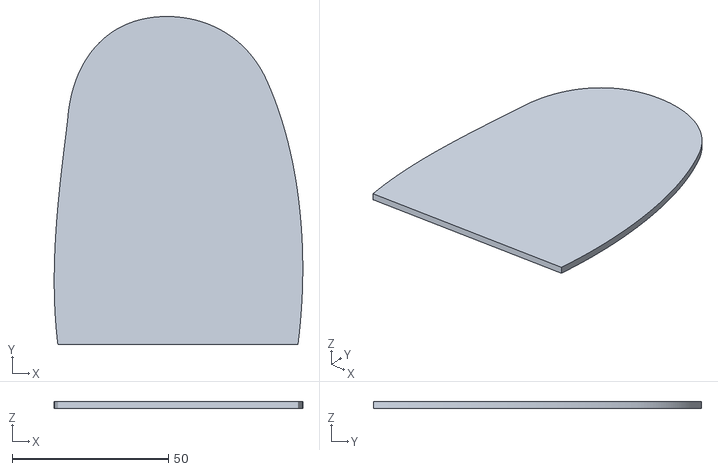
[picture p17: CAD file, 2026-10-17]
insole-cad/stl/bladder_F.stl
79.4 x 104.8 x 2.20
