napatkitiprasanpong/Closed-Loop-Smart-Insole-for-Diabetic-Foot-Ulcer-Prevention/insole-cad/stl/bladder_H.stl

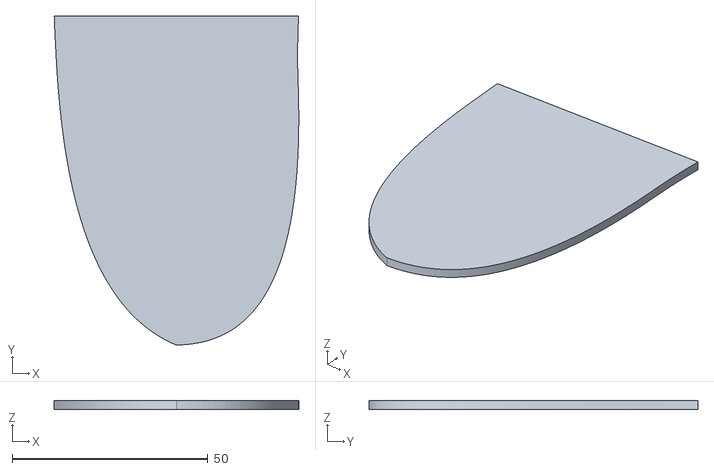
[picture p18: CAD file, 2026-10-17]
insole-cad/stl/bladder_H.stl
62.5 x 84.1 x 2.20
