napatkitiprasanpong/Closed-Loop-Smart-Insole-for-Diabetic-Foot-Ulcer-Prevention/insole-cad/stl/fsr_sensors.stl

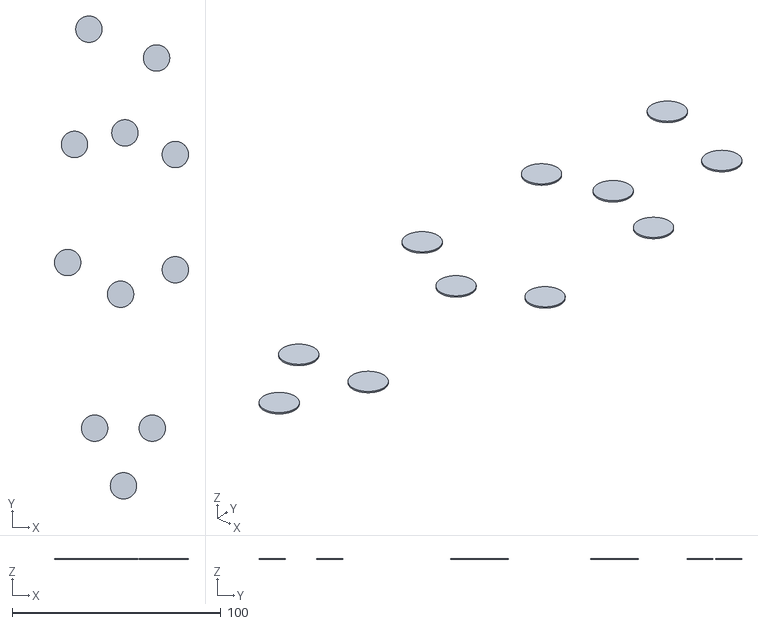
[picture p19: CAD file, 2026-10-17]
insole-cad/stl/fsr_sensors.stl
64.3 x 231.4 x 0.5
