napatkitiprasanpong/Closed-Loop-Smart-Insole-for-Diabetic-Foot-Ulcer-Prevention/insole-cad/stl/bladder_L.stl

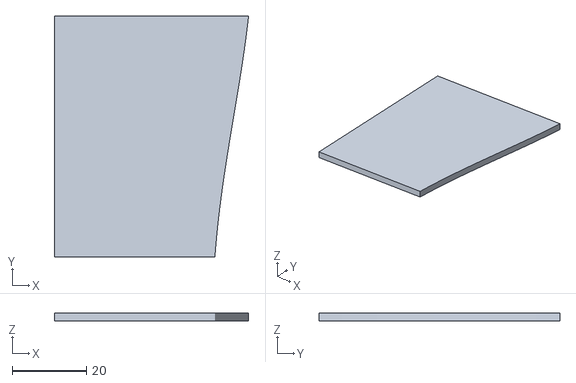
[picture p20: CAD file, 2026-10-17]
insole-cad/stl/bladder_L.stl
52.2 x 64.8 x 2.20
