napatkitiprasanpong/Closed-Loop-Smart-Insole-for-Diabetic-Foot-Ulcer-Prevention/insole-cad/stl/temp_sensors.stl

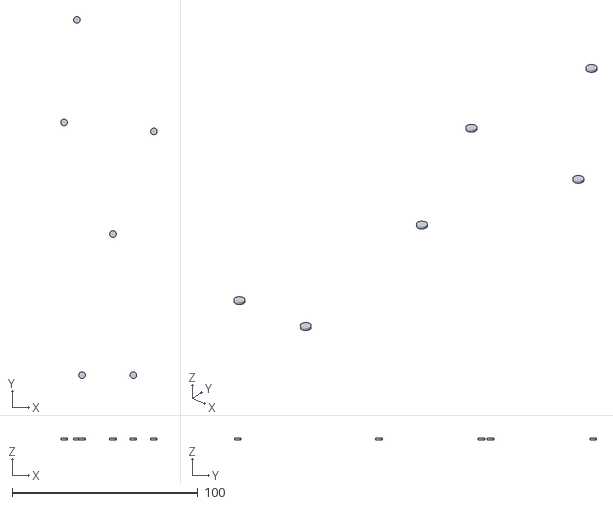
[picture p21: CAD file, 2026-10-17]
insole-cad/stl/temp_sensors.stl
51.9 x 194.7 x 0.9
