napatkitiprasanpong/Closed-Loop-Smart-Insole-for-Diabetic-Foot-Ulcer-Prevention/(list of files, cad)

Other CAD files:
insole-cad/stl/05_top_cover.stl
