napatkitiprasanpong/Closed-Loop-Smart-Insole-for-Diabetic-Foot-Ulcer-Prevention/requirements-and-risk-register.html

# Closed-Loop Smart Diabetic-Foot Prevention System

## Requirements, safety and risk register (draft v0.2 for review)

Status of this document: a working draft for review by a supervisor, clinician or engineer. Items marked TBD need a decision from a reviewer. Numeric targets are proposed prototype targets, not clinically validated values.

## 1. Purpose and scope

A laboratory prototype of a sensorized insole that detects sustained plantar-pressure hotspots, adjusts pneumatic support to redistribute pressure, measures again, and keeps or reverses the change.

In scope (3-month prototype): bench testing of sensing, pneumatic actuation, closed-loop control, dashboard and data logging, aimed at ulcer prevention.

Out of scope for this phase: treatment of existing wounds, testing on active wounds, electrical stimulation, drug delivery, any diagnostic or clinical-effectiveness claim, and any use on people before ethics approval.

Claim to be used: "Existing diabetic-foot technologies generally monitor plantar pressure or temperature and provide warnings. This project investigates automatic, feedback-controlled pressure redistribution using a multimodal sensorized insole."

Changes since v0.1: the status table now covers the safety monitors, CSV replay, firmware skeleton and bench test plan added to the project; the safety table has a status column; the artifacts table was updated. No requirement or target value was changed.

## 2. Current status (honest summary)

Area | Status
Control logic (detect, confirm, adjust, verify, keep or reverse, alert) | Built and unit-tested in simulation only. Walking load: the controller can judge each sensor by its peak over a short window (off by default), tested against a schematic stride model, not measured gait data. FR-03 is met only in that sense; the persistence and window times are placeholders for the clinician
Safety monitors (watchdog, out-of-range and stuck sensors, leak detection, maximum activation time) | Built and unit-tested in simulation only; all limits are placeholder values. Leak detection needs a bladder pressure readback that the board does not have yet
Dashboard (live map, parameters, fault injection, CSV export, CSV replay, serial input) | Built; runs on simulated data. It can replay recorded CSV sessions through the controller (tested) and read a board over Web Serial (parser tested, port handling not tested on hardware)
Insole CAD (layers, bladders, sensor pockets, control box) | Concept model (control box now shows 8 valves, matching the board); not validated by any physical test
Controller board | Schematic-level design; not reviewed by an electronics engineer; not built
Firmware | Skeleton. The portable core (protocol, sensor conversions, valve and pump driver with safety rules) is tested on a PC only; the board code has never been compiled or run; pressure calibration is a placeholder; there is no bladder pressure feedback
Bench test plan | Written (docs/bench-plan.md, six stages); no stage has been run; acceptance numbers are suggestions
Sensors, bladders, pump, valves | Nothing tested physically yet
Clinical input, ethics plan | Not started

The simulation's pressure-transfer behavior is an assumption. Whether real bladders behave this way is the central thing the bench tests must establish.

## 3. Functional requirements

Priority: M = must have for the prototype, S = should have. Verification: T = test, D = demonstration, I = inspection.

ID | Requirement | Proposed target | Pri | Verify
FR-01 | Measure plantar pressure at multiple sites | 8–16 sites (11 in current design) | M | T
FR-02 | Measure skin temperature at multiple sites | 4–8 sites (6 in current design) | M | T
FR-03 | Detect a sustained high-pressure region and ignore normal short gait events | Persistence check; time TBD with clinician | M | T
FR-04 | Control independent pneumatic support zones | 3–4 zones (4 in current design) | M | D
FR-05 | Offload a hotspot by deflating under it or inflating around it, never by inflating directly under it | As described in the plan | M | T
FR-06 | After each adjustment, measure again and keep, reverse or modify it | Verify window: stabilise, then re-measure | M | T
FR-07 | Check all non-target regions and reject an adjustment that creates a comparable hotspot elsewhere | Reject if any other region exceeds the threshold | M | T
FR-08 | Alert the user when safe redistribution cannot be achieved | Visual alert (buzzer optional) | M | D
FR-09 | Record a patient-specific baseline before operation | Per-site baseline; per-patient thresholds TBD | S | T
FR-10 | Combine pressure, temperature rise and loading duration into an explainable risk score | Adjustable weights; pressure drives immediate action, temperature only raises long-term risk or alerts | S | T
FR-11 | Display pressure map, temperature, risk, actuator status and controller state | Live dashboard | M | D
FR-12 | Store session data for later analysis | CSV export of all channels, commands and states | M | I
FR-13 | Report offloading effectiveness | (before − after) / before × 100 | M | T
FR-14 | Run continuously and survive repeated cycling | 2–4 hours continuous; at least 1,000 inflate/deflate cycles | M | T
FR-15 | Repeatable measurements | Each bench condition repeated at least 5 times | M | T

### Performance targets (proposed, to be confirmed)

ID | Target | Value | Verify
PR-01 | Sampling rate per channel | at least 20 Hz | T
PR-02 | Time from sustained hotspot to adjustment starting | persistence time + under 1 s | T
PR-03 | Pressure-sensor repeatability (same load, same site) | TBD after sensor tests | T
PR-04 | Leak rate of a bladder held at working pressure | TBD after bladder tests | T
PR-05 | Insole thickness including bladders | current CAD: 6.6 mm; target TBD with clinician | I

## 4. Safety requirements

ID | Requirement | Verify | Status
SR-01 | A hardware E-stop cuts actuator power independently of firmware | T | Designed in hardware (schematic); not built or tested
SR-02 | All pump and valve outputs are off at power-up and reset | T | Designed (pull-down resistors on the board); the firmware forces outputs off first thing at start-up. Not run on hardware
SR-03 | A maximum bladder pressure is enforced twice: in firmware and by a mechanical relief valve. The limit is TBD, set after bladder burst/leak tests and clinician input | T | Not met today. Mechanical relief valve is in the design only. The firmware limit is not implemented: it needs a bladder pressure sensor, which is not built
SR-04 | A maximum activation time per adjustment, after which the system returns to a safe state | T | Implemented in simulation only (controller limit on time away from neutral; the alert holds until the load is relieved). The firmware limits each valve move to 8 s and the pump to 20 s in a row, tested on a PC only. Limit values TBD
SR-05 | Loss or implausible reading of any sensor puts the system in a fault state and stops further adjustment | T | Implemented in simulation only (lost sensor, out-of-range reading, stuck sensor, missing data). The firmware returns to neutral after 1 s without a command, tested on a PC only. Thresholds are placeholders
SR-06 | The controller never makes an adjustment that raises any region above the threshold; if it does, it reverses and alerts | T | Implemented and unit-tested in simulation only
SR-07 | Bench phase uses a current-limited supply or a protected battery module; no bare lithium cells | I | Process item. The bench plan specifies a current-limited supply; not yet applicable
SR-08 | No use on human subjects until ethics approval is in place and clinical oversight is arranged | I | Process item. The bench plan rules out human use; ethics not started
SR-09 | Every threshold shown in the software is labeled not diagnostic and not clinically validated | I | Not yet checked against the dashboard and deck
SR-10 | Materials touching skin in any future human use must be biocompatible and certified | I | Not applicable until any future human use

## 5. Milestone acceptance criteria

Milestone | Pass when
Month 1 | All sensor locations can be measured and displayed live
Month 2 | The system detects a simulated hotspot, adjusts support automatically, and verifies the result
Month 3 | Bench validation complete: accuracy, repeatability, drift, response time, leakage, false activation, 1,000+ cycles, and a documented safety review

## 6. Risk register

L = likelihood, I = impact (Low / Medium / High).

ID | Risk | L | I | Mitigation | How we will know
R-01 | Core idea does not work physically: deflating a bladder does not reduce pressure at the target without creating another hotspot | M | H | Test early with one bladder and one sensor on a bench rig; fall back to alert plus manual adjustment if needed | Offloading effectiveness and non-target pressures in bench tests
R-02 | Simulation assumptions (pressure transfer, bladder effectiveness) do not match reality | H | M | Replace simulated parameters with measured ones; keep the simulator only for demos | Compare simulated and measured responses
R-03 | Bladders leak or fail under repeated cycling | H | H | Try heat-sealed TPU film and cast silicone; leak test early; 1,000-cycle test | Leak rate; cycles to failure
R-04 | Pressure sensors drift, show hysteresis, or are inaccurate in a curved, flexing insole | H | M | Sensor characterization (Week 2); calibrate against known loads; treat readings as relative | Calibration curves, drift data
R-05 | Insole too thick or stiff to be comfortable | M | M | Thin layers, flexible materials; clinician feedback on acceptable thickness | Thickness and flexibility tests
R-06 | Control oscillates (repeated adjust/re-test cycles) or false-triggers | M | M | Tune persistence, hold and re-test times on real data; test false activation | Event counts in long runs
R-07 | Over-inflation or prolonged loading injures skin in future human use | L | H | Pressure and time limits (SR-03, SR-04), relief valve, no human use in this phase | Safety review before any human test
R-08 | Electrical hazard or ESD through foot-contact wiring; battery hazard | L | H | Low-voltage design, protected battery module, ESD protection at connector, isolation review | Design review
R-09 | Pump noise, power draw or heat unacceptable for wearable use | M | M | Measure noise and power in actuator characterization (Week 5); tethered pump accepted for v1 | Measured values
R-10 | Tubing and wiring route poorly through the insole or shoe | M | M | Protect and shorten routes; redesign in Week 8 | Mechanical inspection
R-11 | Custom board has design errors | M | M | Review by an electronics engineer; prototype first on a dev board and breadboard | Review sign-off; bring-up tests
R-12 | Ethics approval takes longer than the schedule allows | M | M | Plan bench-only work first; start the ethics plan in Week 1 | Approval status
R-13 | Claims go beyond the evidence | M | H | Use the project statement in section 1; label all thresholds as non-diagnostic | Document review
R-14 | No clinical input, so wrong target regions or thresholds | M | H | Meet a diabetic-foot specialist or physical therapist in Week 1 | Meeting notes
R-15 | Skills gap in electronics and mechanical build | H | M | Staged build; reviewer or lab technician support; start with the small first kit | Milestone progress
R-16 | Parts lead time or cost slips the three-month schedule | M | M | Order the small kit first; keep alternates for pump and valves | Order tracking
R-17 | Future human data raises privacy concerns | L | M | Anonymize data; define storage and consent in the ethics plan | Ethics plan

## 7. Assumptions and open questions for the reviewer

Assumptions used so far (all adjustable and unvalidated):

- A hotspot threshold of 400 kPa, persistence of 2 s, and deflation steps of 35% then 20% are demo values.
- Neighbouring zones receive a share of the pressure removed from a deflated zone; the coefficient is invented for the simulation.
- Fill and vent valves are normally closed, so bladders hold pressure when power is lost.
- The walking-load model (a half-sine per sensor, heel first, about 1.1 s per stride, 1.5 s peak-hold window) is a schematic stand-in for real gait data.
- Temperature sensing uses 10 kΩ thermistors; the pump and valves are assumed to be 5 V parts.

Questions for a clinician or diabetic-foot specialist:

1. Which foot regions are highest priority for a first prototype?
2. What pressure and duration patterns would you consider worth acting on?
3. What temperature difference between sites is meaningful?
4. What insole thickness and stiffness would patients tolerate?
5. What would make you trust, or distrust, a device that adjusts support automatically?
6. What pressure should a bladder never exceed against the foot?
7. What would be required before any test on people?

Questions for an electronics or mechanical reviewer:

1. Are the board's power, actuator and sensing sections sound? Please check IC pin numbers against datasheets.
2. Is the 2.5 A actuator rail appropriate for the chosen pump and valves?
3. Is the internal ADC accurate enough, or is an external ADC needed?
4. Which bladder construction is most likely to meet the leak and cycling targets?

## 8. Existing artifacts

Artifact | Supports
Interactive web demo and the offload-demo project (controller, simulator, tests) | FR-03 to FR-08, FR-10 to FR-13, SR-04, SR-05, SR-06 (simulation only); CSV replay supports FR-12 and bench analysis
3D CAD model and layer outlines | FR-04, PR-05, mechanical design
Materials table | Bladder and layer material choices, R-03, R-05
ESP32-S3 board schematic, netlist, BOM, pin map | FR-01, FR-02, FR-04, SR-01, SR-02 (design only)
Firmware skeleton (firmware/) | SR-02, SR-04, SR-05 (core logic tested on a PC only; board code never compiled)
Bench test plan (docs/bench-plan.md) | FR-01, FR-02, PR-03, PR-04, R-01, R-02, R-04 (a plan only; nothing run yet)
