napatkitiprasanpong/Closed-Loop-Smart-Insole-for-Diabetic-Foot-Ulcer-Prevention/(commit log)

2026-10-19 Repo hygiene Added `.gitignore` (node_modules, dist, logs) and `.github/workflows/ci.yml` (typecheck, test, build on every push). `node_modules/` is not in this copy; remove it from git history with 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
    [BOM.xlsx, netlist.csv]
2026-10-20 update 20/10
    [control_box_components.stl]
2026-10-21 update 21/10
    [BOM.xlsx, netlist.csv]
